makkaraayush/Krypton/models/stl/drive_mechanism/README.md

# Servo Drive Mechanism

Contains the servo mounting frame, winch pulleys, cable routing combs, and electronics bracket:
- `RobServoBedV5.stl`: 5-slot mounting bed designed for TowerPro MG996R servos, securing them in a staggered layout along the forearm axis.
- `RobCableFrontV3.stl`: Front cable routing guide that separates and channels the palmar tendon lines toward the wrist pass-through.
- `RobCableBackV3.stl`: Rear cable routing guide maintaining tension line separation for the dorsal return paths.
- `ServoPulleyHitecV5_tighter.stl`: High-torque tendon winch spools with tighter 25T spline engagement (print 5 copies).
- `Bottom_Offset_ServoPulleyHitecV5.stl`: Lower offset pulley spacer for alignment.
- `Top_Offset_Screw_Recess__ServoPulleyHitecV5.stl`: Top pulley cap with M3 screw recess.
- `ardiuinosupport.stl`: Electronics carrier bracket for ESP32 and PCA9685 boards.
