makkaraayush/Krypton/models/stl/armor/README.md

# Outer Cyber Armor

Active Models:
- `coverfinger1.stl`: 5 finger armor shells (split in slicer).
- `topsurfaceUP6.stl`: Updated forearm upper shroud with increased servo horn clearance.

Legacy Models:
- `legacy/topsurface6.stl`: Deprecated stock version (rubbed against servo horns).
