makkaraayush/Krypton/models/stl/fingers/README.md

# Finger STL Assets

Contains the 5 primary finger articulation models:
- `thumb5.stl`: Thumb articulation assembly.
- `Index3.stl`: Index finger assembly.
- `Majeure3.stl`: Middle finger assembly.
- `ringfinger3.stl`: Ring finger assembly.
- `Auriculaire3.stl`: Pinky finger assembly.
