makkaraayush/Krypton/models/3mf/Auriculaire3.3mf

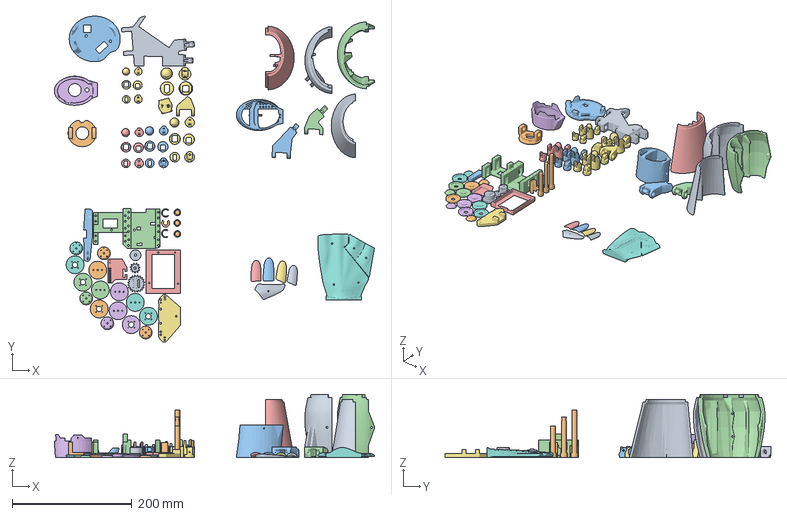
[picture p1: CAD file, 2026-10-23]
models/3mf/Auriculaire3.3mf
536.3 x 545.5 x 105.6 mm
WristlargeV4.stl
Bolt_entretoise7.stl
rotawrist1V3.stl
RobServoBedV5.stl
ardiuinosupport.stl
rotawrist2.stl
RobCableFrontV3.stl
topsurfaceUP6.stl
WristGearsV4.stl
rotawrist3V2.stl
RobCableBackV3.stl
robpart5V4.stl
cableholderwristV4.stl
ServoPulleyHitecV5_tighter.stl x 5
thumb5.stl
robpart4V4.stl
robcap3V2.stl
robpart2V4.stl
Majeure3.stl
Bottom_Offset_ServoPulleyHitecV5.stl x 5
robpart3V4.stl
Index3.stl
ringfinger3.stl
Auriculaire3.stl
coverfinger1.stl_1
Top_Offset_Screw_Recess__ServoPulleyHitecV5.stl x 5
coverfinger1.stl_2
coverfinger1.stl_3
coverfinger1.stl_4
coverfinger1.stl_5
WristsmallV4.stl_1
WristsmallV4.stl_2
