makkaraayush/Krypton/models/stl/armor/topsurfaceUP6.stl

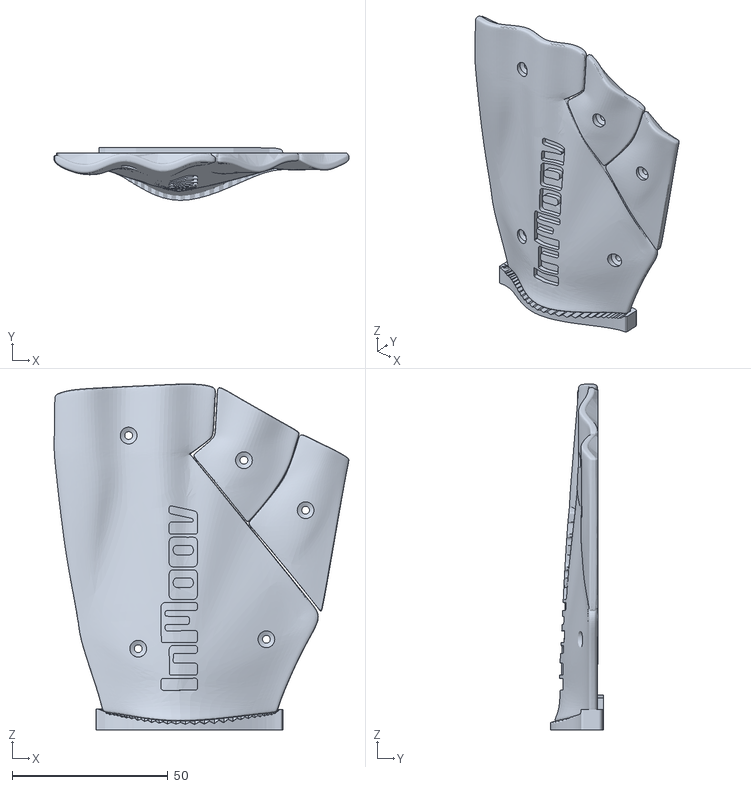
[picture p2: CAD file, 2026-10-18]
models/stl/armor/topsurfaceUP6.stl
94.7 x 17.0 x 111.2
