makkaraayush/Krypton/models/stl/drive_mechanism/RobCableBackV3.stl

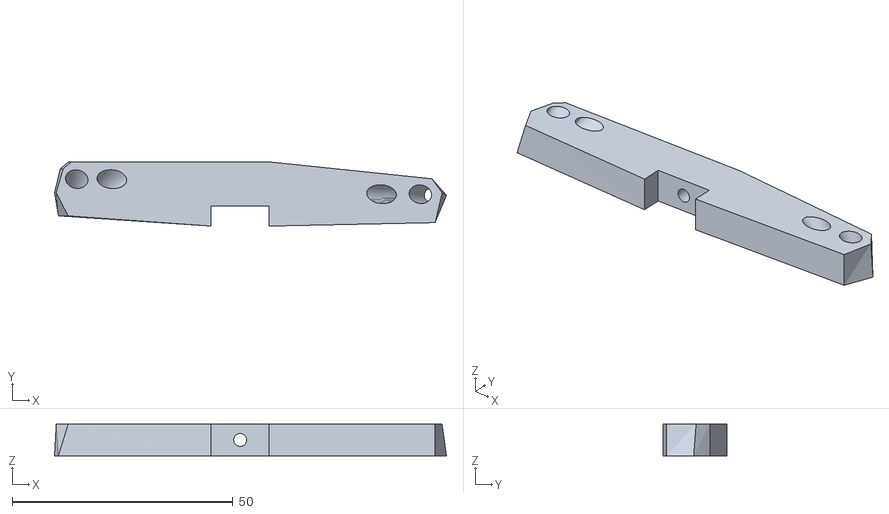
[picture p3: CAD file, 2026-10-22]
models/stl/drive_mechanism/RobCableBackV3.stl
88.7 x 14.5 x 7.17
