makkaraayush/Krypton/models/stl/fingers/ringfinger3.stl

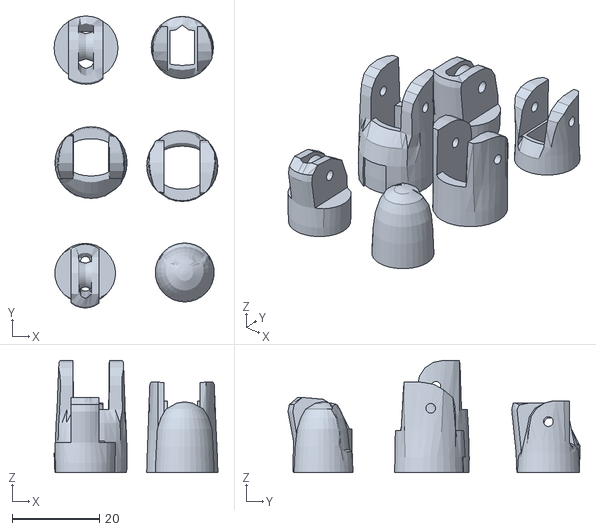
[picture p4: CAD file, 2026-10-11]
models/stl/fingers/ringfinger3.stl
37.6 x 67.0 x 25.8
