makkaraayush/Krypton/models/stl/forearm/robpart1V2.stl

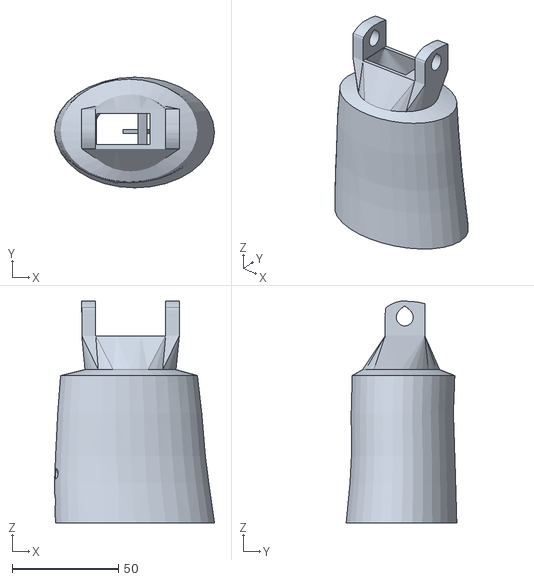
[picture p5: CAD file, 2026-10-22]
models/stl/forearm/robpart1V2.stl
75.5 x 52.2 x 104.7
