makkaraayush/Krypton/models/stl/wrist/rotawrist3V2.stl

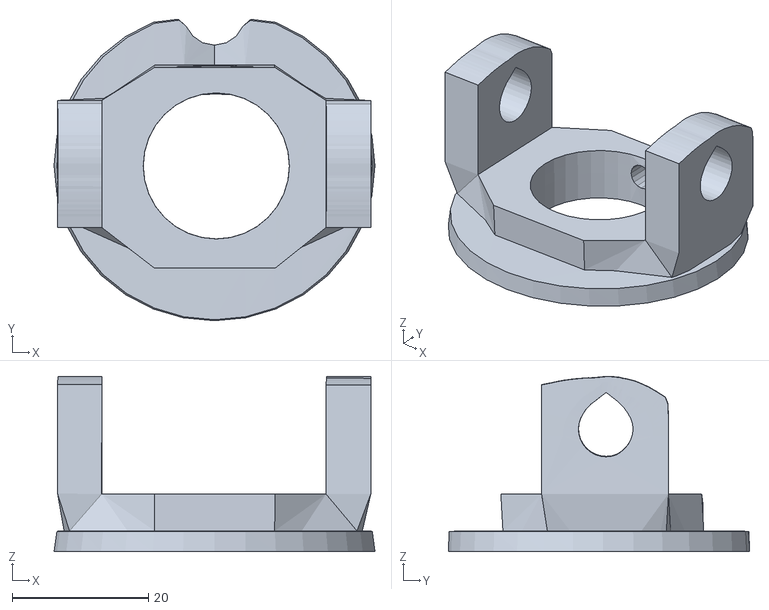
[picture p6: CAD file, 2026-10-23]
models/stl/wrist/rotawrist3V2.stl
47.2 x 44.3 x 25.7
