makkaraayush/Krypton/models/3mf/Krypton_Bambu_A1_AMS_Plates.3mf

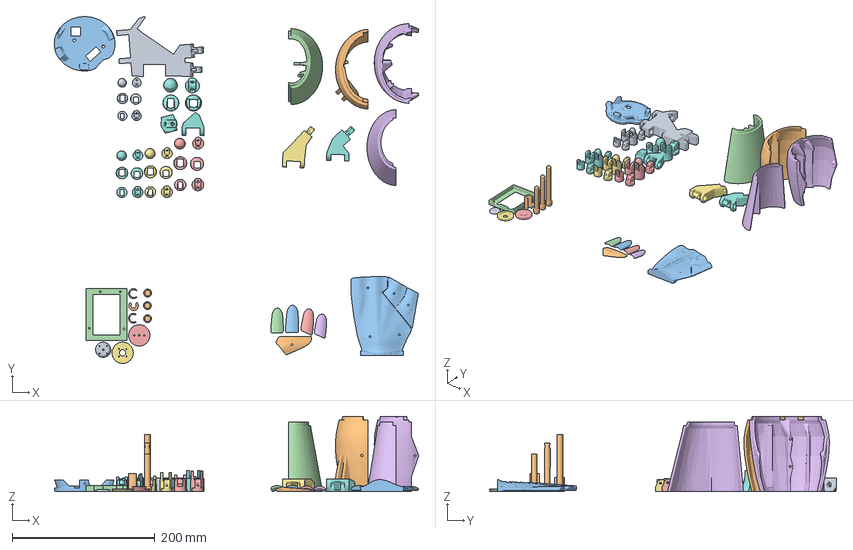
[picture p7: CAD file, 2026-10-18]
models/3mf/Krypton_Bambu_A1_AMS_Plates.3mf
511.4 x 486.7 x 105.6 mm
WristlargeV4.stl
Bolt_entretoise7.stl
topsurfaceUP6.stl
ardiuinosupport.stl
ServoPulleyHitecV5_tighter.stl
robpart5V4.stl
Bottom_Offset_ServoPulleyHitecV5.stl
thumb5.stl
Top_Offset_Screw_Recess__ServoPulleyHitecV5.stl
robpart4V4.stl
robcap3V2.stl
robpart2V4.stl
Majeure3.stl
robpart3V4.stl
Index3.stl
ringfinger3.stl
Auriculaire3.stl
coverfinger1.stl_1
coverfinger1.stl_2
coverfinger1.stl_3
coverfinger1.stl_4
coverfinger1.stl_5
WristsmallV4.stl_1
WristsmallV4.stl_2
