makkaraayush/Krypton/models/stl/armor/topsurface6.stl

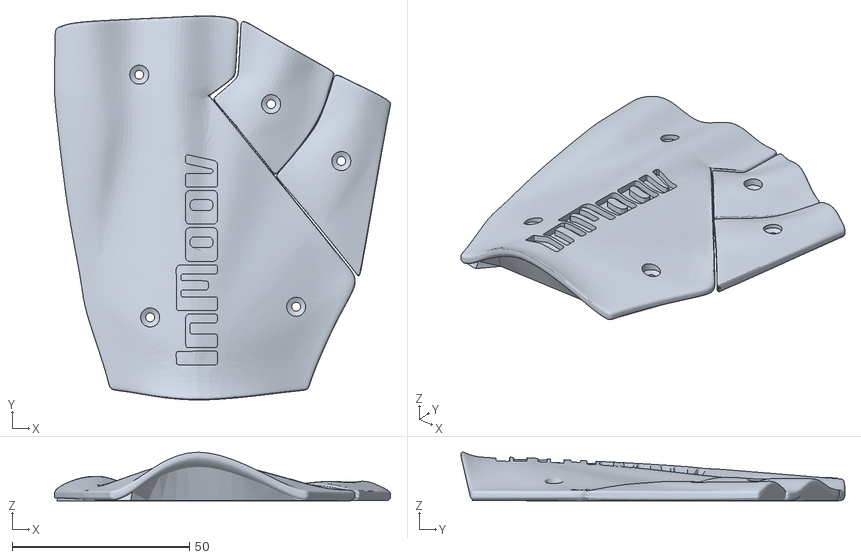
[picture p8: CAD file, 2026-10-17]
models/stl/armor/topsurface6.stl
94.8 x 108.3 x 13.7
