makkaraayush/Krypton/models/stl/drive_mechanism/RobCableFrontV3.stl

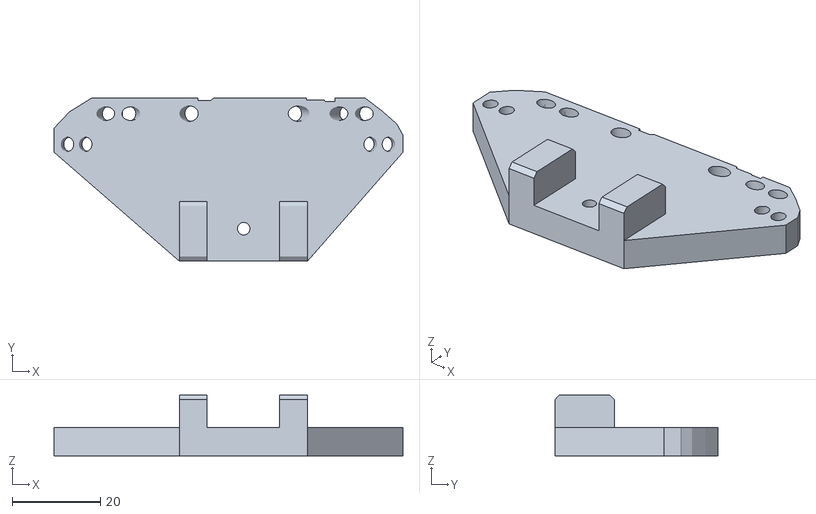
[picture p9: CAD file, 2026-10-22]
models/stl/drive_mechanism/RobCableFrontV3.stl
79.3 x 37.1 x 13.8
