makkaraayush/Krypton/models/stl/fingers/Majeure3.stl

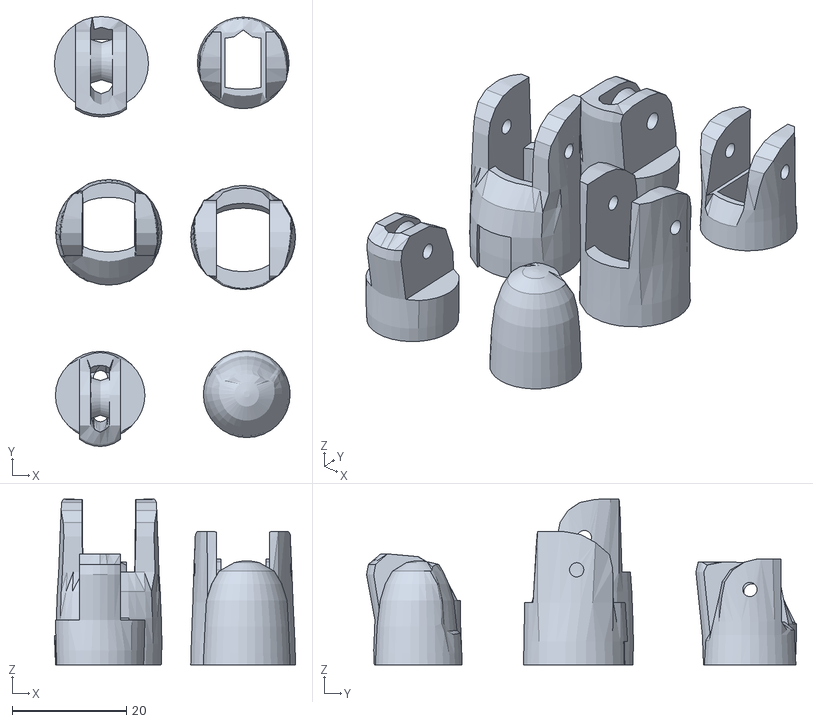
[picture p10: CAD file, 2026-10-11]
models/stl/fingers/Majeure3.stl
42.2 x 75.2 x 29.0
