makkaraayush/Krypton/models/stl/forearm/robpart5V4.stl

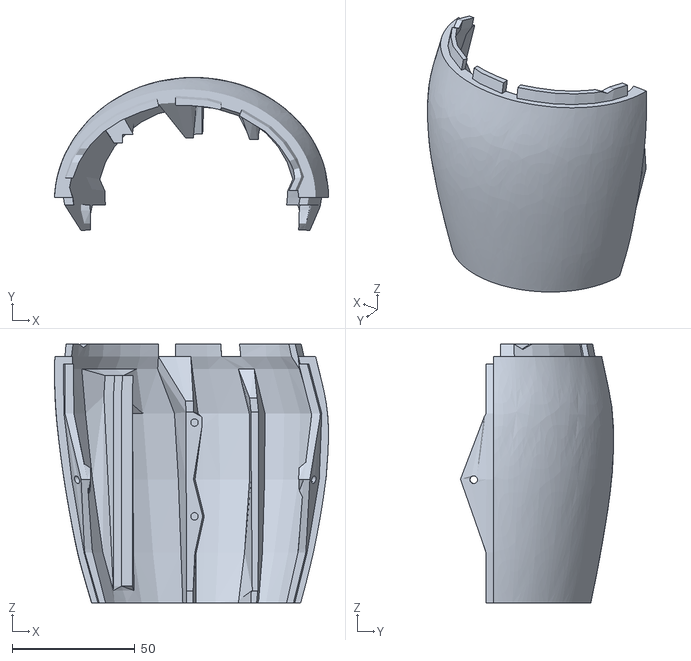
[picture p11: CAD file, 2026-10-12]
models/stl/forearm/robpart5V4.stl
111.8 x 62.5 x 105.6
