makkaraayush/Krypton/models/stl/wrist/rotawrist1V3.stl

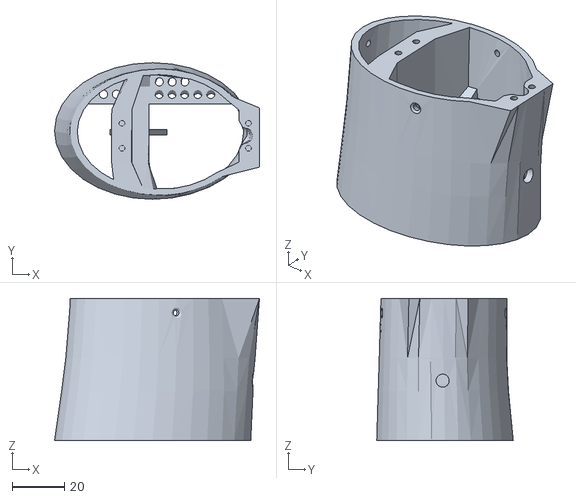
[picture p12: CAD file, 2026-10-23]
models/stl/wrist/rotawrist1V3.stl
78.4 x 52.2 x 54.4
