makkaraayush/Krypton/models/stl/armor/coverfinger1.stl

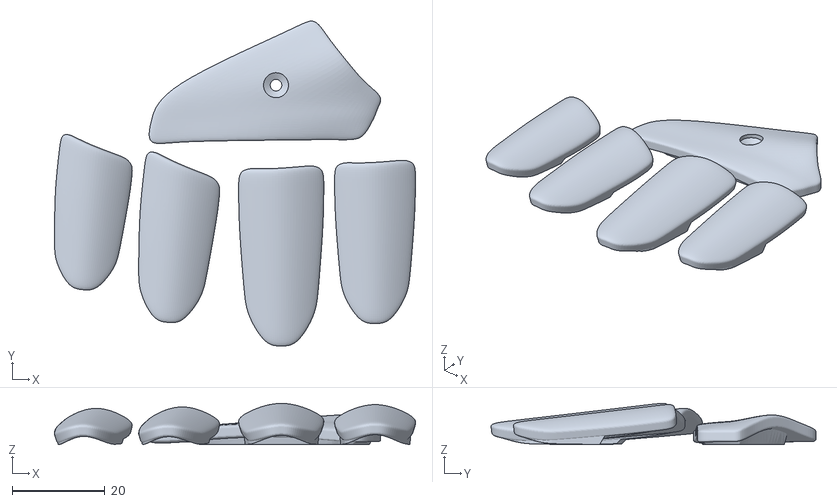
[picture p13: CAD file, 2026-10-17]
models/stl/armor/coverfinger1.stl
77.7 x 69.9 x 8.87
