makkaraayush/Krypton/models/stl/drive_mechanism/RobServoBedV5.stl

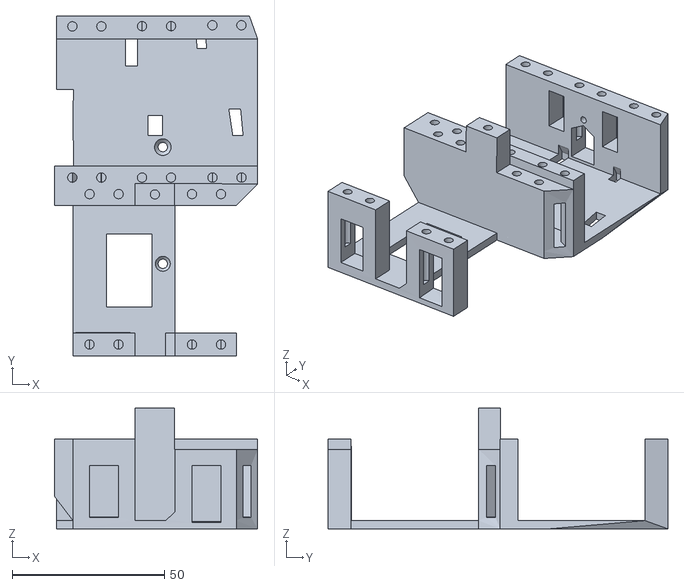
[picture p14: CAD file, 2026-10-22]
models/stl/drive_mechanism/RobServoBedV5.stl
66.7 x 111.6 x 39.7
