makkaraayush/Krypton/models/stl/fingers/Index3.stl

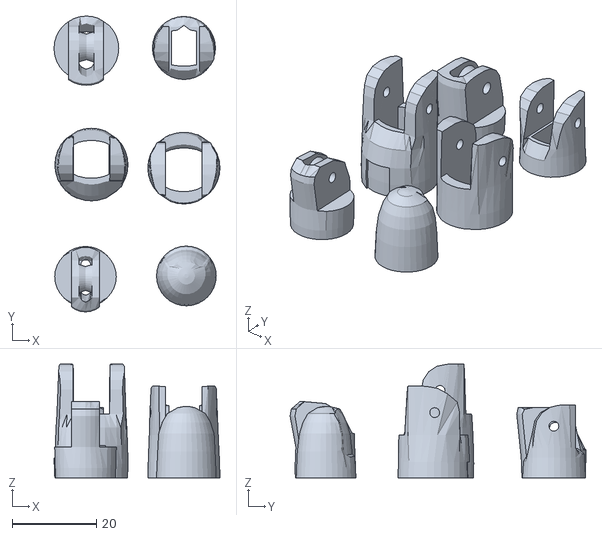
[picture p15: CAD file, 2026-10-11]
models/stl/fingers/Index3.stl
39.4 x 70.2 x 27.0
