makkaraayush/Krypton/models/stl/forearm/robpart4V4.stl

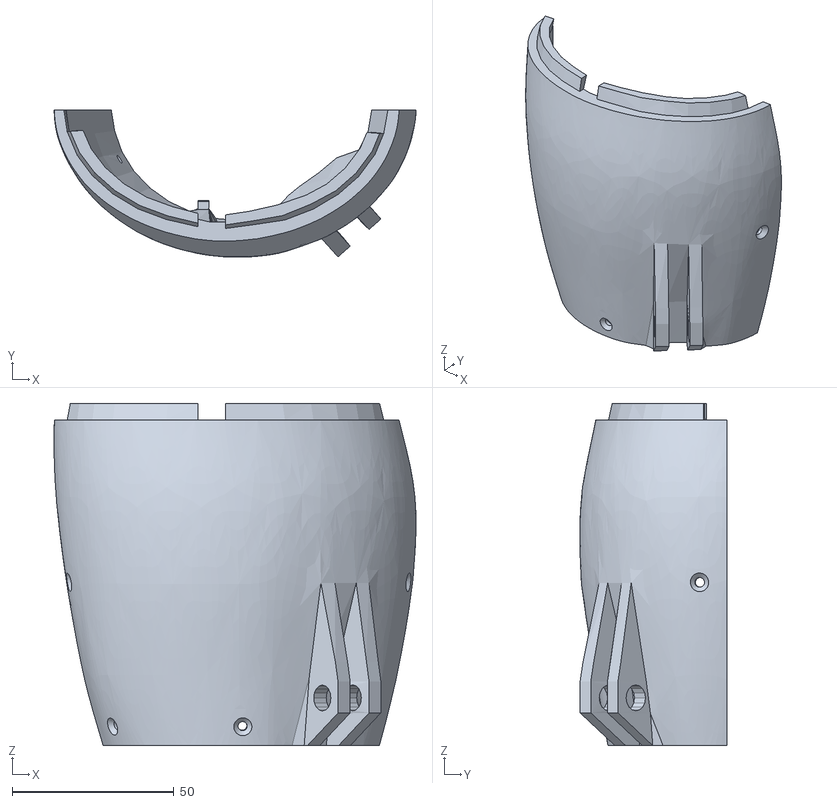
[picture p16: CAD file, 2026-10-12]
models/stl/forearm/robpart4V4.stl
111.8 x 45.5 x 105.6
