makkaraayush/Krypton/models/stl/wrist/rotawrist2.stl

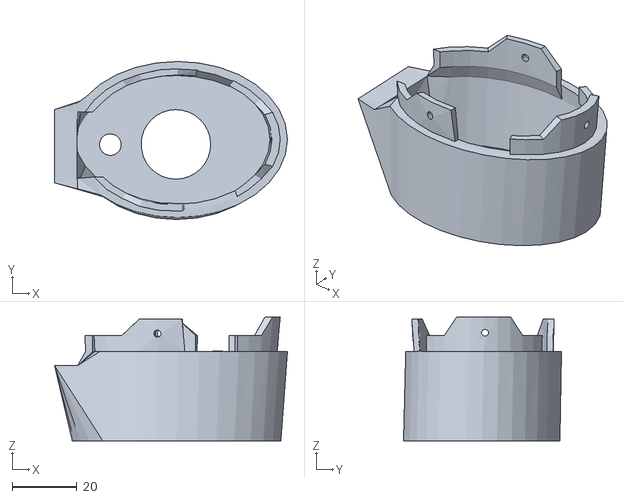
[picture p17: CAD file, 2026-10-23]
models/stl/wrist/rotawrist2.stl
72.1 x 48.9 x 38.3
