makkaraayush/Krypton/models/stl/drive_mechanism/Bottom_Offset_ServoPulleyHitecV5.stl

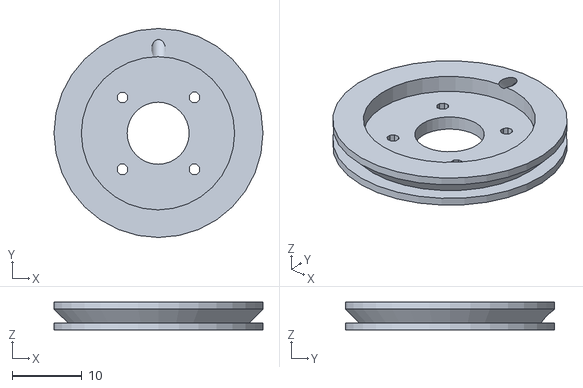
[picture p18: CAD file, 2026-10-14]
models/stl/drive_mechanism/Bottom_Offset_ServoPulleyHitecV5.stl
30.0 x 30.0 x 4.00
