makkaraayush/Krypton/models/stl/fingers/thumb5.stl

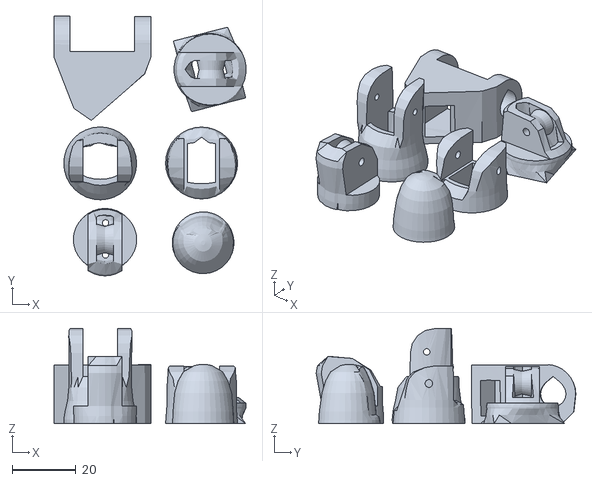
[picture p19: CAD file, 2026-10-11]
models/stl/fingers/thumb5.stl
60.1 x 81.2 x 29.8
