makkaraayush/Krypton/models/stl/forearm/robpart2V4.stl

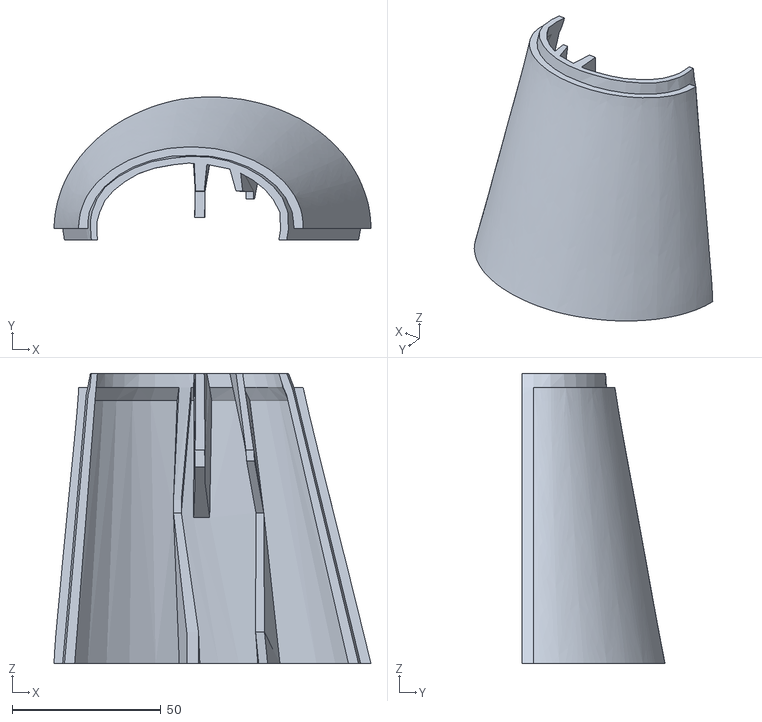
[picture p20: CAD file, 2026-10-12]
models/stl/forearm/robpart2V4.stl
106.4 x 48.1 x 97.5
