makkaraayush/Krypton/models/stl/wrist/WristGearsV4.stl

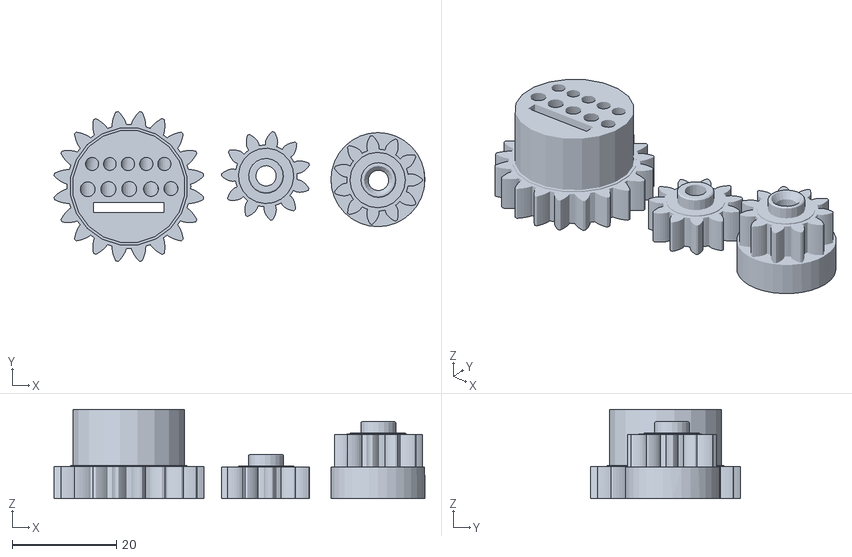
[picture p21: CAD file, 2026-10-23]
models/stl/wrist/WristGearsV4.stl
71.0 x 28.7 x 17.1
