makkaraayush/Krypton/models/stl/drive_mechanism/ServoPulleyHitecV5_tighter.stl

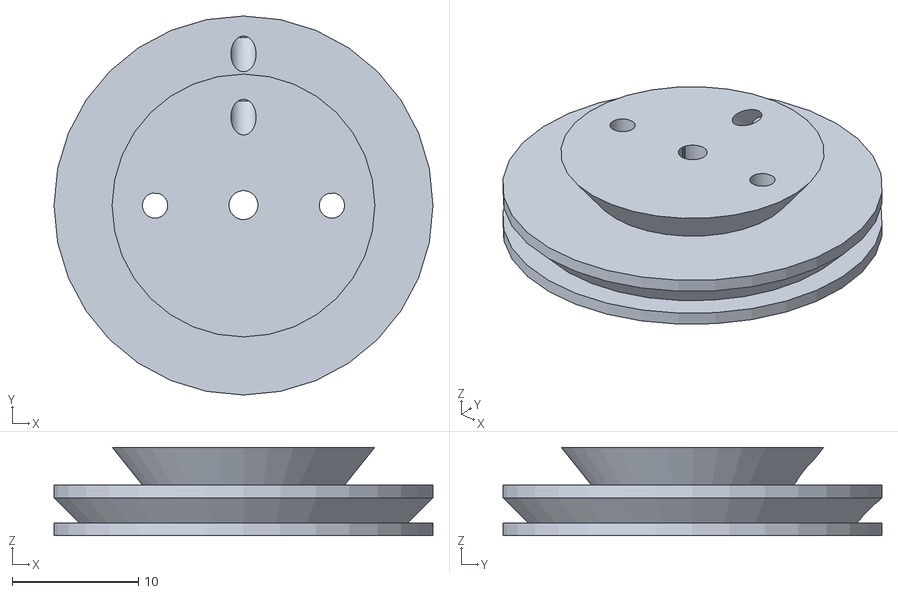
[picture p22: CAD file, 2026-10-14]
models/stl/drive_mechanism/ServoPulleyHitecV5_tighter.stl
30.0 x 30.0 x 7.00
