makkaraayush/Krypton/models/stl/fingers/Auriculaire3.stl

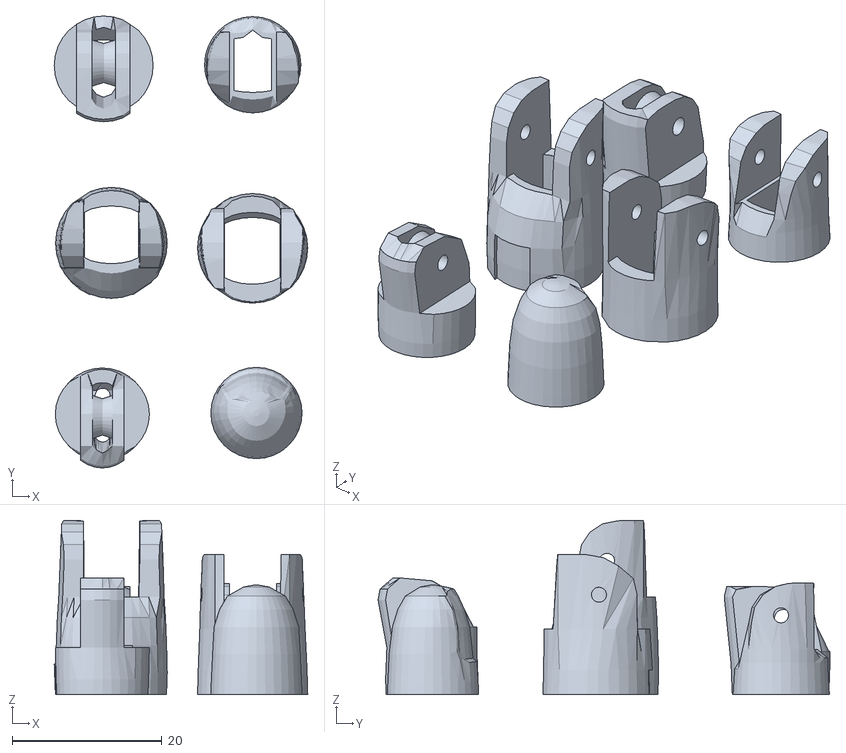
[picture p23: CAD file, 2026-10-11]
models/stl/fingers/Auriculaire3.stl
33.8 x 60.3 x 23.2
