makkaraayush/Krypton/models/stl/forearm/robcap3V2.stl

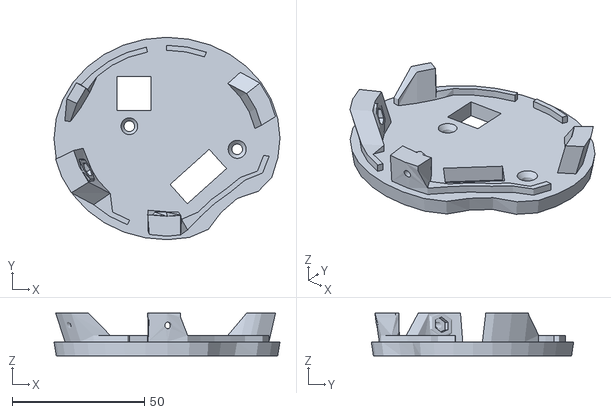
[picture p24: CAD file, 2026-10-12]
models/stl/forearm/robcap3V2.stl
85.5 x 76.5 x 16.2
