makkaraayush/Krypton/models/stl/wrist/cableholderwristV4.stl

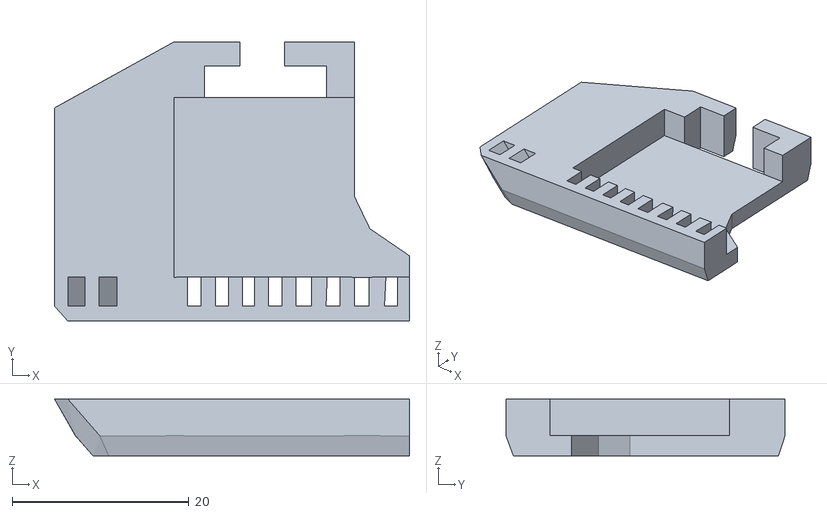
[picture p25: CAD file, 2026-10-23]
models/stl/wrist/cableholderwristV4.stl
40.2 x 31.6 x 6.44
