makkaraayush/Krypton/models/stl/forearm/robpart3V4.stl

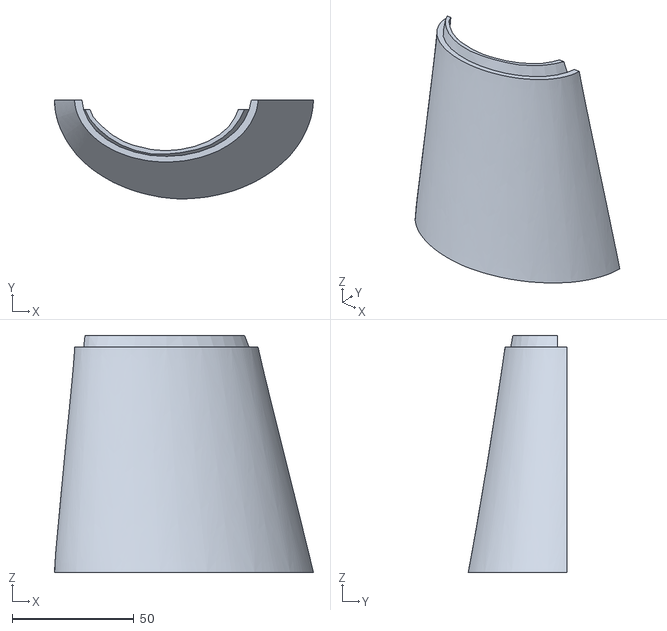
[picture p26: CAD file, 2026-10-12]
models/stl/forearm/robpart3V4.stl
106.4 x 40.6 x 97.5
