makkaraayush/Krypton/models/stl/drive_mechanism/ardiuinosupport.stl

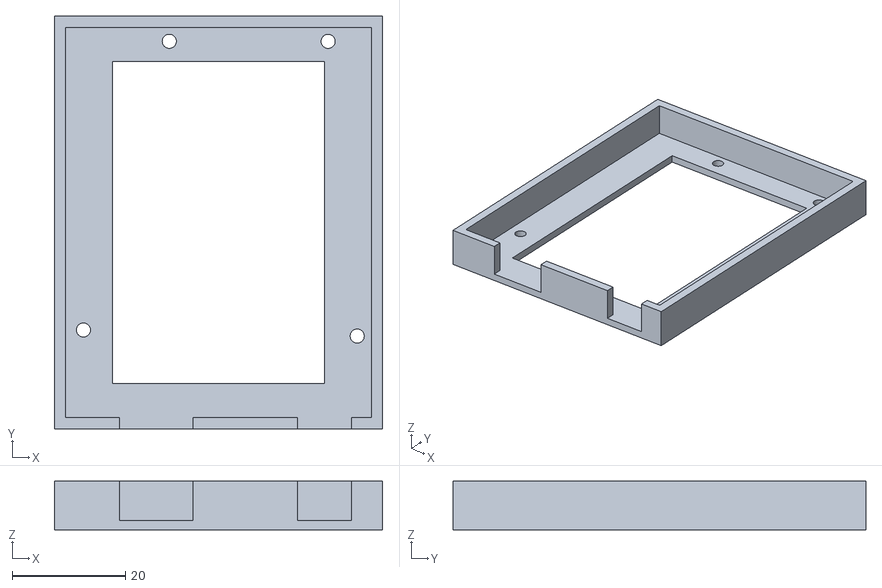
[picture p27: CAD file, 2026-10-14]
models/stl/drive_mechanism/ardiuinosupport.stl
58.0 x 73.0 x 8.62
