makkaraayush/Krypton/models/stl/wrist/WristsmallV4.stl

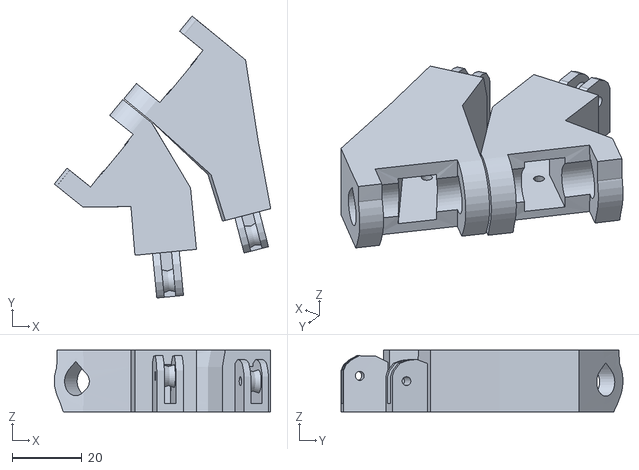
[picture p28: CAD file, 2026-10-12]
models/stl/wrist/WristsmallV4.stl
62.0 x 80.8 x 17.7
