makkaraayush/Krypton/models/stl/wrist/WristlargeV4.stl

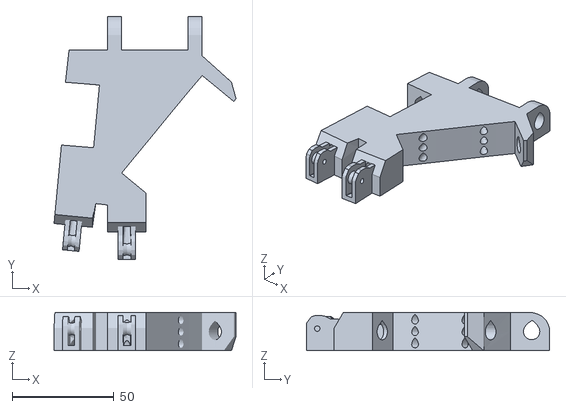
[picture p29: CAD file, 2026-10-12]
models/stl/wrist/WristlargeV4.stl
89.2 x 119.4 x 18.9
