makkaraayush/Krypton/(list of files, cad)

Other CAD files:
models/stl/drive_mechanism/Top_Offset_Screw_Recess__ServoPulleyHitecV5.stl
models/stl/wrist/Bolt_entretoise7.stl
