makkaraayush/Krypton/firmware/esp32_servo_tester/README.md

# Standalone ESP32 Servo Tester & Bench Calibration Guide

This directory contains an interactive ESP32 bench testing sketch designed specifically for testing your TowerPro MG996R servos with a **12V battery**, the **SZBK07 300W 20A buck converter**, and the **PCA9685 16-channel PWM driver**.

It does not require Wi-Fi, WebSockets, or OpenCV. It runs directly via the Arduino IDE Serial Monitor at 115200 baud.

---

## 1. Hardware Overview

- **Power Source**: 12V Battery (3S Li-ion 11.1V-12.6V or 12V Lead-Acid / LiFePO4).
- **Voltage Regulator**: SZBK07 (300W 20A Constant-Current / Constant-Voltage Synchronous Step-Down Buck Converter).
- **Controller**: ESP32 Type-C (38-pin or 30-pin CP2102).
- **PWM Driver**: PCA9685 16-Channel 12-bit I2C driver (Address `0x40`).
- **Servos**: 6x TowerPro MG996R metal-gear servos (Channels 0 to 4: Fingers, Channel 5: Wrist Rotation).

---

## 2. Crucial Pre-Power SZBK07 Calibration (DO THIS FIRST)

> **CRITICAL WARNING**: The SZBK07 buck converter arrives from the manufacturer with its trimmer screws set at unknown positions. If you hook your 12V battery up and plug directly into your PCA9685 without calibrating, it could deliver 11V to 12V directly to your 6V servos and burn out their control boards instantly.

Follow these 4 calibration steps before plugging anything into the converter output:

1. **Disconnect All Loads**:
   Keep the PCA9685, ESP32, and all servos completely disconnected from the buck converter output.
2. **Connect 12V Battery**:
   Connect your 12V battery positive lead to `IN+` and negative lead to `IN-` on the SZBK07 terminal blocks. The onboard power LED will light up.
3. **Calibrate Voltage (CV Trimmer)**:
   - Set your digital multimeter to DC Volts ($20\text{V}$ range).
   - Place the black multimeter probe on `OUT-` and the red probe on `OUT+`.
   - Locate the **CV (Constant Voltage)** brass trimmer screw (located next to the output terminals).
   - Using a small flathead screwdriver, turn the CV trimmer counter-clockwise until the multimeter reads **exactly 6.00V DC** (acceptable range: $5.95\text{V}$ to $6.05\text{V}$).
4. **Open Current Throttle (CC Trimmer)**:
   - Locate the **CC (Constant Current)** brass trimmer screw (located toward the middle of the board).
   - Turn the CC trimmer screw **12 to 15 full revolutions clockwise**.
   - This opens up the current path to its full 20A limit so the converter will not choke or drop voltage when multiple servos pull peak stall current together.

---

## 3. Wiring Diagram

```
[ 12V Battery ]
      │
      ├──(+)──> [IN+] SZBK07 300W 20A Buck [OUT+ (6.0V)] ──> [PCA9685 Green Screw V+]
      └──(–)──> [IN-] SZBK07 300W 20A Buck [OUT- (GND)]  ──> [PCA9685 Green Screw GND]

[ PCA9685 Left 6-Pin Header ]                   [ ESP32 (Type-C / DevKit) ]
  ├── V+  (6.0V Motor Rail) ───────────────────> 5V / VIN Pin  (Powers ESP32 onboard 3.3V LDO)
  ├── GND (Common Ground)   ───────────────────> GND Pin
  ├── VCC (3.3V Logic Rail) <─────────────────── 3.3V Pin (Powers PCA9685 chip)
  ├── SDA (I2C Data)        <─────────────────── GPIO 21
  ├── SCL (I2C Clock)       <─────────────────── GPIO 22
  └── OE  (Output Enable)   (Leave Disconnected)

[ PCA9685 3-Pin Servo Headers (Channels 0 to 5) ]
  ├── Channel 0 ──> Thumb MG996R Servo
  ├── Channel 1 ──> Index MG996R Servo
  ├── Channel 2 ──> Middle (Majeure) MG996R Servo
  ├── Channel 3 ──> Ring MG996R Servo
  ├── Channel 4 ──> Pinky (Auriculaire) MG996R Servo
  └── Channel 5 ──> Wrist Rotation MG996R Servo
```

> **Clean Wiring Tip**: The `V+` pin on the PCA9685's left 6-pin header is directly tied to the 6.0V motor rail from the green screw terminal! You can run a single 5-wire female-to-female Dupont ribbon cable between the PCA9685 left header and your ESP32.
> 
> *Note on the ESP32 `5V` pin*: On USB Type-C ESP32 development boards, the external power input pin is typically labeled **`5V`**, **`V5`**, or **`5V0`** rather than `VIN`. They are electrically the exact same pin—both route directly to the onboard LDO voltage regulator, which converts 5.0V–6.0V down to a stable 3.3V.

---

## 4. Connection Pinout Tables

### A. Power Connections

| Source Point | Target Destination | Wire Type | Purpose |
| :--- | :--- | :--- | :--- |
| `SZBK07 OUT+ (6.0V)` | `PCA9685 V+` (Green screw terminal) | 18/20 AWG Silicone | Main servo power feed |
| `PCA9685 Left Header V+` | `ESP32 5V / VIN` pin | 22/24 AWG Dupont | Powers ESP32 onboard 3.3V LDO regulator |
| `SZBK07 OUT- (GND)` | `PCA9685 GND` (Green screw terminal) | 18/20 AWG Silicone | Main ground return |
| `PCA9685 Left Header GND` | `ESP32 GND` pin | 22/24 AWG Dupont | Common ground reference |

### B. Logic Connections (ESP32 to PCA9685)

| ESP32 Pin | PCA9685 Pin | Wire Color | Notes |
| :--- | :--- | :--- | :--- |
| `3.3V` | `VCC` | Red Dupont | **Never connect to 6V!** PCA9685 logic must match ESP32 3.3V rail. |
| `GND` | `GND` | Black Dupont | Common logic ground. |
| `GPIO 21` | `SDA` | Green / Blue | I2C Serial Data line. |
| `GPIO 22` | `SCL` | Yellow / White | I2C Serial Clock line. |
| *(None)* | `OE` | Leave Disconnected | Output Enable is active-low with internal pull-down. |

### C. MG996R Servo 3-Pin Lead Color Code

| Servo Wire Color | Header Row on PCA9685 | Function |
| :--- | :---: | :--- |
| **Brown** | Bottom Row (`GND` / Black) | Ground |
| **Red** | Middle Row (`V+` / Red) | +6.0V Motor Power |
| **Orange / Yellow** | Top Row (`PWM` / Yellow) | 50Hz Control Signal |

---

## 5. How to Flash & Run the Test Suite

1. **Open Sketch**:
   Open `firmware/esp32_servo_tester/esp32_servo_tester.ino` in Arduino IDE.
2. **Board Configuration**:
   - Board: `ESP32 Dev Module`
   - Upload Speed: `921600`
   - Port: Select your ESP32 COM port (e.g. `COM3` on Windows).
3. **Upload**:
   Click **Upload**. No third-party libraries need to be installed; it uses the built-in `Wire.h` library.
4. **Open Serial Monitor**:
   - Set baud rate to **115200**.
   - Set line ending to **Newline** or **Both NL & CR**.
   - Press the `EN` / `RST` button on your ESP32.

---

## 6. Interactive Serial Commands

When the sketch boots, it will automatically check for the PCA9685 at address `0x40`. If found, it automatically homes all 6 servos to their calibrated neutral positions:
- **Fingers (CH 0-4)**: Homing to `0 deg` (fully open hand).
- **Wrist (CH 5)**: Homing to `90 deg` (straight / neutral center; 0 deg = left rotation, 180 deg = right rotation).

| Command | Action | Purpose |
| :--- | :--- | :--- |
| `0` to `5` | Selects active channel (0:Thumb, 1:Index, 2:Middle, 3:Ring, 4:Pinky, 5:Wrist) | Switch active joint/finger |
| `wrist` / `thumb`... | Directly selects channel by name (`thumb`, `index`, `middle`, `ring`, `pinky`, `wrist`) | Named quick-switch |
| `<ch> <angle>` | Moves specified channel directly (e.g. `5 90`, `wrist 180`, `1 45`) | One-shot positioning |
| `<any angle>` | Moves active channel to specified degrees (0-180) | Fine positional testing |
| `all <angle>` | Moves all 6 channels simultaneously (e.g. `all 90`) | Coordinated positioning |
| `center` or `c` | Moves wrist to straight neutral (`90 deg`) | Quick wrist center |
| `left` or `l` | Rotates wrist left (`0 deg`) | Quick wrist left |
| `right` or `r` | Rotates wrist right (`180 deg`) | Quick wrist right |
| `s` | Sweeps active channel smoothly (Fingers: 0->180->0, Wrist: 90->0->180->90) | Checks joint friction / gear binding |
| `w` or `wf` | **SWEEPS 5 FINGERS ONLY** (Wrist holds steady at 90 deg neutral) | Daily finger articulation test |
| `wa` or `wall` | **STRESS TEST: SWEEPS ALL 6 SERVOS TOGETHER** (5 fingers + wrist) | Verifies SZBK07 buck under full load |
| `z` | Homes all servos (Fingers: 0 deg open, Wrist: 90 deg straight) | **Mandatory before mounting pulleys & gears** |
| `p` | Cycles through preset poses (Open, Fist, Point, Peace, Wrist Left, Wrist Right, etc.) | Demonstrates full articulation |
| `+` or `+5` | **TIGHTEN**: Increases active finger `pulseMax` by 5 ticks | Tightens loose finger at 180 deg |
| `-` or `-5` | **RELIEVE**: Decreases active finger `pulseMax` by 5 ticks | Eliminates servo hum / buzz |
| `+10` / `-10` | Adjusts active finger `pulseMax` by 10 ticks | Coarse tension tuning |
| `max <ticks>` | Sets `pulseMax` directly for active channel (e.g. `max 550`) | Precise custom endpoint |
| `min <ticks>` | Sets `pulseMin` directly for active channel (e.g. `min 102`) | Precise custom home position |
| `pulse <ticks>` | Sends raw PWM ticks directly to active servo (e.g. `pulse 545`) | Direct hardware test without mapping |
| `comp` | Displays current wrist decoupling compensation table | View tension offsets |
| `comp on/off` | Toggles automatic wrist-tendon decoupling compensation | Enables/disables auto-tension fix |
| `comp <ch> <k>`| Calibrates decoupling factor for a finger (e.g. `comp 4 0.15` or `comp pinky 0.18`) | Fine-tunes rotation compensation |
| `<angle>` | Moves active channel to angle 0 to 200 (e.g. `185`, `190` for extra pull) | Over-rotation test |
| `status` | Prints live angles, home positions, pulse limits, and decoupling coeffs | Comprehensive diagnostic |
| `trim <min> <max>` | Sets custom pulse limits (e.g. `trim 102 550`) | Full range calibration |
| `scan` | Runs live I2C bus scanner | Verifies SDA/SCL wiring if board isn't found |
| `gpio <angle>` | Drives a single servo on ESP32 GPIO 18 directly | Test without PCA9685 attached |
| `?` or `help` | Prints command reference list | Cheat sheet |

---

## 7. Recommended Bench Testing Sequence

1. **Multimeter Check**: Verify `OUT+` on the SZBK07 is measuring 6.00V DC.
2. **Flash the Sketch**: Upload and open the Serial Monitor at 115200 baud.
3. **Verify Homing (`z`)**: Send `z`. Fingers (0-4) rotate to 0 degrees (open hand) and Wrist (5) rotates to 90 degrees (straight neutral).
4. **Mount Pulleys & Wrist Gears**: With power active and servos actively holding their positions:
   - Press the yellow `ServoPulleyHitecV5_tighter.stl` winches onto finger servos 0-4 with string tie holes aligned straight toward the forearm.
   - Press the wrist drive gear (`WristGearsV4.stl`) onto servo 5 with the hand and forearm mechanically aligned straight ahead (90 deg neutral).
5. **Individual Sweep (`0`, then `s`, `1`, then `s`... `5`, then `s`)**: Test each finger and the wrist rotation one by one. Check that lines wind cleanly and the wrist ring rotates smoothly without tooth skipping.
6. **Sweep Fingers (`w`) & Stress Test (`wa`)**: Send `w` to sweep just the 5 fingers while the wrist holds straight at 90 deg. Send `wa` to sweep all 6 servos together under full electrical load. Place your multimeter across `OUT+` and `OUT-` on the SZBK07. The voltage should remain between $5.90\text{V}$ and $6.05\text{V}$ without resetting the ESP32.

---

## 8. Troubleshooting Loose Fingers at 180 Degrees

### Why do some fingers not fully close at 180 degrees?
1. **Clock Oscillator Variance**: PCA9685 internal oscillators nominally run at 25MHz, but clone breakout boards frequently oscillate at 26.5MHz to 27MHz. Under an uncalibrated 50Hz prescaler, 512 ticks delivers only ~2.3ms of pulse width instead of 2.5ms, which restricts the MG996R servo to only ~160 degrees of rotation.
2. **Missing Spool Travel**: 20 degrees of lost servo rotation means the winch spool fails to take up the final 4mm to 6mm of braided line. Because the tendon is not pulled all the way, the knuckles remain semi-open and loose.
3. **Previous Truncation Limits**: Older sketches hardcoded `pulseMax` to 505 (Pinky) or 508 (Ring), which prematurely clamped rotation before the servos reached mechanical full sweep.

### How to eliminate loose fingers live on the bench:
1. Select the loose finger (e.g. `4` for Pinky, or type `pinky`).
2. Command it to `180` (or `4 180`).
3. If the knuckles are not fully clenched, send `+` (or `+5`). The servo will immediately turn an additional 5 ticks and pull the tendon tighter.
4. Continue typing `+` until the finger closes completely into a tight, rigid fist.
5. If the motor begins to buzz or strain against a hard stop, type `-` to back off 5 ticks.
6. Type `status` to inspect your final calibrated `PulseMax` values, and transfer them to `firmware/esp32_krypton/config.h`.

---

## 9. Wrist Rotation Tendon Decoupling Compensation

### The Mechanical Coupling Phenomenon
Because the 5 finger braided lines route through the rotating wrist collar (`Bolt_entretoise7.stl` and `cableholderwristV4.stl`), rotating the wrist mechanically alters the path length of the tendon lines:
- **Rotating Left (< 90°)**: Outer lines (especially the Pinky on CH 4 and Ring on CH 3) wrap around a longer exterior circumference arc. Without compensation, the Pinky tendon tightens involuntarily simply because the wrist turned left.
- **Rotating Right (> 90°)**: The opposite side of the wrist experiences path length changes while Pinky/Ring slacken.

### Kinematic Decoupling Formula
Both `esp32_servo_tester` and `esp32_krypton` include an active kinematic decoupling compensator:
$$\Delta \theta_{\text{wrist}} = \theta_{\text{wrist}} - 90.0^\circ$$
$$\theta_{\text{hardware}}[i] = \theta_{\text{target}}[i] + K_{\text{comp}}[i] \times \Delta \theta_{\text{wrist}}$$

- When rotating Left ($\Delta \theta_{\text{wrist}} < 0$), a positive coefficient ($+0.15$) automatically relaxes the Pinky servo angle by up to $13.5^\circ$, keeping the physical finger at constant tension without curling involuntarily.
- When rotating Right ($\Delta \theta_{\text{wrist}} > 0$), it takes up slack smoothly.

### Calibrated Default Decoupling Coefficients
| Channel | Finger | Default $K_{\text{comp}}$ | Behavior on Left Rotation |
| :---: | :--- | :---: | :--- |
| CH 0 | Thumb | `-0.10` | Slight tension increase |
| CH 1 | Index | `-0.05` | Slight tension increase |
| CH 2 | Middle | `0.00` | Center rotation axis (zero shift) |
| CH 3 | Ring | `+0.08` | Relaxes servo to offset arc stretch |
| CH 4 | Pinky | `+0.15` | Relaxes servo to offset arc stretch |

You can dynamically fine-tune these live in the Serial Monitor using:
```text
comp pinky 0.18
comp ring 0.10
comp status
```
