makkaraayush/Krypton/docs/calibration_guide.md

# Calibration & Tuning Guide

Achieving smooth, lifelike movement requires electrical, mechanical, and software calibration.

---

## 1. Electrical Calibration

Always verify voltages with a multimeter before powering electronics:
- **Buck Converter Output**: Must read **6.0V DC +/- 0.05V**.
- **PCA9685 V+**: Must measure 6.0V.
- **PCA9685 VCC**: Must measure 3.3V (from ESP32 3.3V rail).
- **ESP32 VIN**: Receives 6.0V (onboard LDO regulates to 3.3V).

---

## 2. Software Pulse Limits & Per-Finger Trims

In `firmware/esp32_krypton/config.h`:
```cpp
// Per-finger pulse trims (12-bit PCA9685 ticks, 0 to 4095 @ 50Hz)
const uint16_t SERVO_PULSE_MIN_MAP[NUM_SERVOS] = { 102, 102, 102, 102, 102, 102 }; // Thumb, Index, Mid, Ring, Pinky, Wrist
const uint16_t SERVO_PULSE_MAX_MAP[NUM_SERVOS] = { 540, 550, 545, 540, 540, 540 }; // Index: 550 (+10), Middle: 545 (+5)
```

Different production batches of TowerPro MG996R servos have slight internal potentiometer variations. Rather than un-screwing the winch spool and jumping teeth on the 25T spline, you can fine-tune mechanical end-stops in firmware:

1. **Test Channel Centering**:
   Run the CLI test tool to command a single finger to 0 degrees:
   ```bash
   python tools/servo_test.py --mode udp --channel 1 --angle 0
   ```
2. **Listen for Potentiometer Jitter**:
   If the servo motor buzzes or hums at 0 degrees, it is being mechanically forced against its internal physical stop. Increase `SERVO_PULSE_MIN_MAP` for that channel by 3 to 5 ticks (e.g. from `102` to `106`).
3. **Verify Full Contraction**:
   Command the finger to 180 degrees:
   ```bash
   python tools/servo_test.py --mode udp --channel 1 --angle 180
   ```
   If the finger stops short of a complete fist, increase `SERVO_PULSE_MAX_MAP` slightly until full grip closure is achieved.

---

## 3. Tendon Tension Tuning

- **Under-tensioned**: Finger fails to close completely when servo reaches 180 degrees. Solution: Untie knot, pull 2-3mm tighter, re-glue.
- **Over-tensioned**: Servo buzzes continuously at 0 degrees and draws >1.5A stall current. Solution: Loosen the palmar line slightly or adjust the 0-degree angle to 5 degrees in firmware.

---

## 4. Wrist Rotation Tendon Decoupling Compensation

When the wrist rotates away from its straight neutral position (90°), tendon lines passing through the wrist collar stretch or slacken around the curved circumference:
- **Left Rotation (< 90°)**: Outer fingers (especially Pinky and Ring) experience increased path length and tighten involuntarily.
- **Right Rotation (> 90°)**: Outer fingers slacken while inner lines experience slight tension changes.

To maintain steady finger grip regardless of wrist orientation, the firmware applies kinematic decoupling compensation:
```cpp
delta_wrist = wrist_angle - 90.0f;
effective_angle[i] = target_angle[i] + (WRIST_COMP_COEFFS[i] * delta_wrist);
```

Default calibrated coefficients in `config.h`:
- Thumb (CH 0): `-0.10`
- Index (CH 1): `-0.05`
- Middle (CH 2): `0.00` (aligned with central rotation axis)
- Ring (CH 3): `+0.08`
- Pinky (CH 4): `+0.15`

You can dynamically fine-tune or disable compensation live during bench testing:
```text
comp on          -> Enable compensation
comp off         -> Disable compensation
comp 4 0.18      -> Set Pinky compensation coefficient to +0.18
comp status      -> Inspect live decoupling table
```
