makkaraayush/Krypton/firmware/esp32_krypton/config.h

#ifndef CONFIG_H
#define CONFIG_H

#include <Arduino.h>

// ==========================================
// Krypton Bionic Arm - Pin & Hardware Config
// ==========================================

// I2C Bus Configuration for PCA9685 PWM Driver
#define I2C_SDA_PIN         21
#define I2C_SCL_PIN         22
#define I2C_CLOCK_SPEED     400000  // Fast mode 400kHz

#define PCA9685_I2C_ADDR    0x40    // Default address with all address solder pads open
#define PWM_FREQUENCY       50      // 50Hz for analog/digital hobby servos (20ms cycle)

// PCA9685 Channel Mapping (6 MG996R Servos: 5 Fingers + Wrist)
#define CH_THUMB            0
#define CH_INDEX            1
#define CH_MIDDLE           2
#define CH_RING             3
#define CH_PINKY            4
#define CH_WRIST            5

#define NUM_SERVOS          6

// Pulse Width Calibration (12-bit timer: 0 to 4095 ticks at 50Hz / 20ms period)
// 102 ticks ~= 500 us (0 degrees / fully open / wrist left)
// 540-550 ticks ~= 2500-2650 us (180 degrees / full tight grip on MG996R)
// Calibrated per finger:
//   Index  (CH 1): 550 (+10 ticks for full tight curl)
//   Middle (CH 2): 545 (+5 ticks for full tight curl)
const uint16_t SERVO_PULSE_MIN_MAP[NUM_SERVOS] = { 102, 102, 102, 102, 102, 102 }; // Thumb, Index, Mid, Ring, Pinky, Wrist
const uint16_t SERVO_PULSE_MAX_MAP[NUM_SERVOS] = { 540, 550, 545, 540, 540, 540 };

// Legacy single-value fallback constants
#define SERVO_PULSE_MIN     102
#define SERVO_PULSE_MAX     540

// Per-channel angle limits (degrees: 0 to 180)
const int SERVO_MIN_ANGLES[NUM_SERVOS] = { 0,   0,   0,   0,   0,   0   };
const int SERVO_MAX_ANGLES[NUM_SERVOS] = { 180, 180, 180, 180, 180, 180 };

// Default home positions on boot / reset (Fingers = 0 deg open, Wrist = 90 deg straight)
const float SERVO_HOME_ANGLES[NUM_SERVOS] = { 0.0f, 0.0f, 0.0f, 0.0f, 0.0f, 90.0f };

// Direction Inversion (Set true if spool rotation tightens tendon in reverse direction)
const bool SERVO_INVERT[NUM_SERVOS]    = { false, false, false, false, false, false };

// ==========================================
// Wrist Rotation Tendon Decoupling Compensation
// ==========================================
// As the wrist rotates away from 90 deg, tendons routing around the rotating collar
// shift path length. Rotating left (<90) tightens outer fingers (especially Pinky/Ring).
// Positive coefficient: finger tightens on left rotation (wrist < 90), so servo relaxes angle.
// Formula: hw_angle[i] = target_angle[i] + (WRIST_COMP_COEFFS[i] * (wrist_angle - 90.0f))
#define ENABLE_WRIST_COMPENSATION true
const float WRIST_COMP_COEFFS[5] = { -0.10f, -0.05f, 0.00f, 0.08f, 0.15f }; // Thumb, Index, Middle, Ring, Pinky

// ==========================================
// Network & Telemetry Settings
// ==========================================

// SoftAP Mode (Direct Phone/Laptop Connection without external router)
#define AP_SSID             "Krypton-Arm"
#define AP_PASSWORD         "cyberpunk2026"
#define AP_CHANNEL          1
#define AP_MAX_CONN         4

// Station Mode (Optional: connect to home Wi-Fi)
#define STA_SSID            "Your_WiFi_SSID"
#define STA_PASSWORD        "Your_WiFi_Password"
#define ENABLE_STA_MODE     false

#define HTTP_SERVER_PORT    80
#define WS_SERVER_PORT      81
#define UDP_SERVER_PORT     8888
#define SERIAL_BAUD_RATE    115200

// ==========================================
// Motion Smoothing & Collision Avoidance
// ==========================================
// Prevents abrupt jerk and tendon snaps by stepping current angle towards target
#define MOTION_SMOOTHING             true
#define TRAJECTORY_STEP_DEG          16.0f   // High-speed tracking step (~2000 deg/sec) for true real-time replication
#define TRAJECTORY_INTERVAL_MS       8       // Ultra-fast easing loop update interval (125 Hz)

// Intelligent Thumb & Finger Collision Avoidance
// Prevents mechanical entrapment when transitioning between FIST, POINT, and OPEN poses:
// 1. If Index/Middle is opening from under a clamped thumb, Thumb yields to clearance angle first.
// 2. When forming a fist, fingers curl into the palm first before Thumb folds over the outside.
// 3. If Thumb is trapped under curled fingers and wants to open, fingers yield clearance first.
#define ENABLE_COLLISION_AVOIDANCE   true
#define THUMB_CLEARANCE_ANGLE        85.0f   // Safe clearance angle for thumb (safe till 85 deg for index)
#define FINGER_CLEARANCE_ANGLE       45.0f   // Angle below which index/middle are considered cleared
#define COLLISION_ZONE_MIN           85.0f   // Minimum angle where thumb physically overlaps index

#endif // CONFIG_H
