makkaraayush/Krypton/(commit log)

2026-10-11 cad: import base finger STLs (thumb, index, middle, ring, pinky)
    [Auriculaire3.stl, Index3.stl, Majeure3.stl, ringfinger3.stl, thumb5.stl]
2026-10-12 cad: add forearm chassis sections robpart2-5 and wrist bearings
    [WristlargeV4.stl, WristsmallV4.stl, robcap3V2.stl, robpart2V4.stl, robpart3V4.stl, robpart4V4.stl, robpart5V4.stl]
2026-10-13 docs: draft initial BOM with dowel pins and Uno controller
2026-10-14 hardware: optimize BOM - replace dowel pins with M3x20 socket screws and nyloc nuts
2026-10-14 cad: add servo winch pulleys and electronics mounting bracket
    [Bolt_entretoise7.stl, Bottom_Offset_ServoPulleyHitecV5.stl, ServoPulleyHitecV5_tighter.stl, Top_Offset_Screw_Recess__ServoPulleyHitecV5.stl, ardiuinosupport.stl]
2026-10-15 arch: switch microcontroller architecture from Uno to ESP32 + PCA9685
2026-10-15 power: document 3S battery regulation and 300W 20A buck converter calibration
2026-10-16 firmware: initial ESP32 PCA9685 I2C communication and servo test sweep
2026-10-17 cad: import outer cyber armor shells (coverfinger1 and topsurface6)
    [coverfinger1.stl, topsurface6.stl]
2026-10-17 cad: note servo clearance collision on topsurface6 during dry fit
2026-10-18 cad: update to topsurfaceUP6 - delete carved logo and increase servo clearance
    [topsurface6.stl, topsurfaceUP6.stl]
2026-10-18 slicer: configure Bambu A1 + AMS Lite 5-spool palette and 4-plate consolidation
    [Krypton_Bambu_A1_AMS_Plates.3mf]
2026-10-19 slicer: add glow modifier strips to finger covers and tune AMS flush matrix
2026-10-19 firmware: implement async webserver and REST API endpoints for servo control
2026-10-20 firmware: build responsive cyberpunk web dashboard with finger sliders and presets
2026-10-20 firmware: add trajectory smoothing and software easing to prevent tendon snap
    [esp32_krypton.ino, pca9685_driver.h]
2026-10-21 vision: add cyberpunk HUD overlay with per-finger live tension bars
2026-10-21 docs: complete mechanical assembly guide and tendon rigging sequence
2026-10-21 docs: add servo zeroing, tensioning, and troubleshooting guides
2026-10-22 fix(vision): bootstrap pip, pin mediapipe 0.10.14 and protobuf 4 for Windows compatibility
2026-10-22 fix(vision): isolate thumb joint curvature from lateral abduction and add zero-tare rest calibration
    [hand_tracker.py, visualizer.py]
2026-10-22 cad: add forearm base section robpart1V2 to complete chassis spine
    [robpart1V2.stl]
2026-10-22 cad: add 5-servo bed frame RobServoBedV5 for MG996R cluster
    [RobServoBedV5.stl]
2026-10-22 cad: add front and back tendon cable routing guides RobCableFront and RobCableBack
    [RobCableBackV3.stl, RobCableFrontV3.stl]
2026-10-22 docs: update mechanical assembly steps for servo bed and cable guides
2026-10-23 cad: add wrist tendon routing collar cableholderwristV4
    [cableholderwristV4.stl]
2026-10-23 cad: add wrist rotation ring segments rotawrist1-3 and internal drive gears
    [WristGearsV4.stl, rotawrist1V3.stl, rotawrist2.stl, rotawrist3V2.stl]
2026-10-23 slicer: import dedicated Auriculaire3 3MF profile for pinky finger bed orientation
    [Auriculaire3.3mf]
2026-10-23 docs: update plate schedule and filament assignments for full mechanical assembly
2026-10-24 firmware: add per-finger calibration pulse trim arrays in config.h
2026-10-24 firmware: update PCA9685 driver to support per-finger pulse mapping
2026-10-24 firmware: update web dashboard UI with new preset buttons and live ping indicator
2026-10-25 vision: improve serial error resilience and automatic reconnect loop
    [communicator.py]
2026-10-25 tools: add standalone CLI servo test utility for single-channel verification
2026-10-26 hardware: update BOM with fasteners for RobServoBedV5 and robpart1 chassis
2026-10-26 hardware: add wire harness routing and servo lead strain relief notes to wiring guide
2026-10-26 docs: add individual finger pulse trimming walkthrough to calibration guide
2026-10-26 docs: add tendon knot slippage prevention and friction relief to troubleshooting
2026-10-26 firmware: add UDP telemetry timeout failsafe to prevent stalled tension hold
    [esp32_krypton.ino]
2026-10-26 docs: update hardware guide summaries with wiring strain relief and BOM counts
2026-10-27 firmware: add standalone ESP32 servo test sketch and wiring guide for 12V battery and SZBK07 buck converter
2026-10-27 docs: document 5-wire header connection using PCA9685 V+ pin to power ESP32 VIN
2026-10-27 docs: clarify that 5V pin on Type-C ESP32 functions identically to VIN
2026-10-27 fix(firmware): support ESP32 Arduino Core 3.0+ ledcAttach API alongside Core 2.x
    [esp32_servo_tester.ino]
2026-11-01 hardware: standardize BOM to M3 hex screws and document 3D printed M8 wrist pins
2026-11-01 firmware: add standalone ESP8266 servo test suite for pulley testing
2026-11-01 firmware: harmonize esp8266_servo_tester to match esp32_servo_tester line-for-line
2026-11-01 revert: restore esp32_servo_tester to original state
    [esp32_servo_tester.ino]
2026-11-01 fix(firmware): make esp8266_servo_tester exact clone of esp32 tester and enable PCA9685 totem pole mode
    [esp8266_servo_tester.ino]
2026-11-01 firmware: add standalone direct single-servo tester for ESP8266 on pin D5
2026-11-01 docs: document hardware challenges and rotational tensioning technique
2026-11-02 firmware: expand esp32_servo_tester to 6 channels for wrist rotation
2026-11-02 firmware: fix loose fingers at 180 degrees by raising pulse limits and adding live tightening controls
    [config.h, esp32_servo_tester.ino, esp8266_servo_tester.ino]
2026-11-02 firmware: add wrist-tendon decoupling compensation, 6-channel wrist controls, custom pulse limits, and dual sweep modes
2026-11-03 Optimize ESP32 serial parser with non-blocking ring buffer and add COM port busy detection
2026-11-03 Add intelligent thumb-finger collision avoidance and anti-snag sequence to trajectory engine
    [config.h, esp32_servo_tester.ino, pca9685_driver.h]
2026-11-03 firmware: resolve thumb-finger pre-tightening conflict with dynamic clearance yield and full clench follow-through
    [esp32_servo_tester.ino, pca9685_driver.h]
2026-11-03 firmware: isolate thumb collision strictly to index conflict and add vision kinematics calibration tuner
    [calibration.py, esp32_servo_tester.ino, hand_tracker.py, pca9685_driver.h, tuner.py]
2026-11-03 firmware: enable 100Hz dynamic trajectory acceleration; vision: implement horizontal thumb sweep and monotonic finger fist kinematics
2026-11-03 vision: fix index occlusion drop under thumb and calibrate pinky bone length ratio
    [hand_tracker.py]
2026-11-03 firmware: implement hardware index pulley safety interlock; vision: restore stable finger tracking and add fist occlusion safeguard
2026-11-03 firmware: clean index safety interlock; vision: restore pure index tracking identical to other fingers
2026-11-03 firmware: update thumb safety clearance to 85 deg; vision: add downward distal curl vector to prevent premature half-curl saturation
    [calibration.py, config.h, hand_tracker.py, pca9685_driver.h]
2026-11-03 vision: restore proven natural 4-finger kinematics with calibrated pinky span
